Hamid-R-Tanhaei/Signal-Generator/Extras/App.png

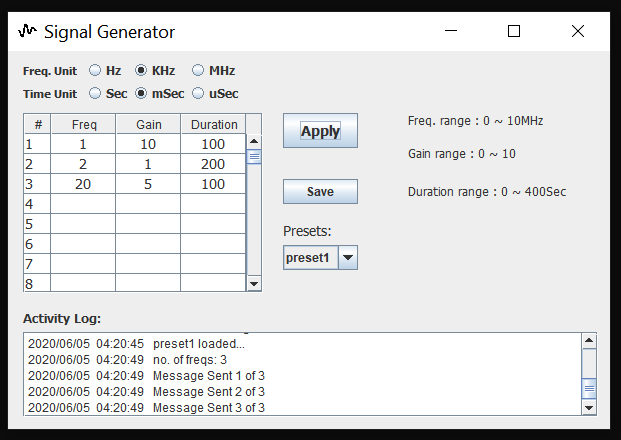
Extras/App.png
