Hamid-R-Tanhaei/Signal-Generator/PCB_Schematic/schematic.PDF

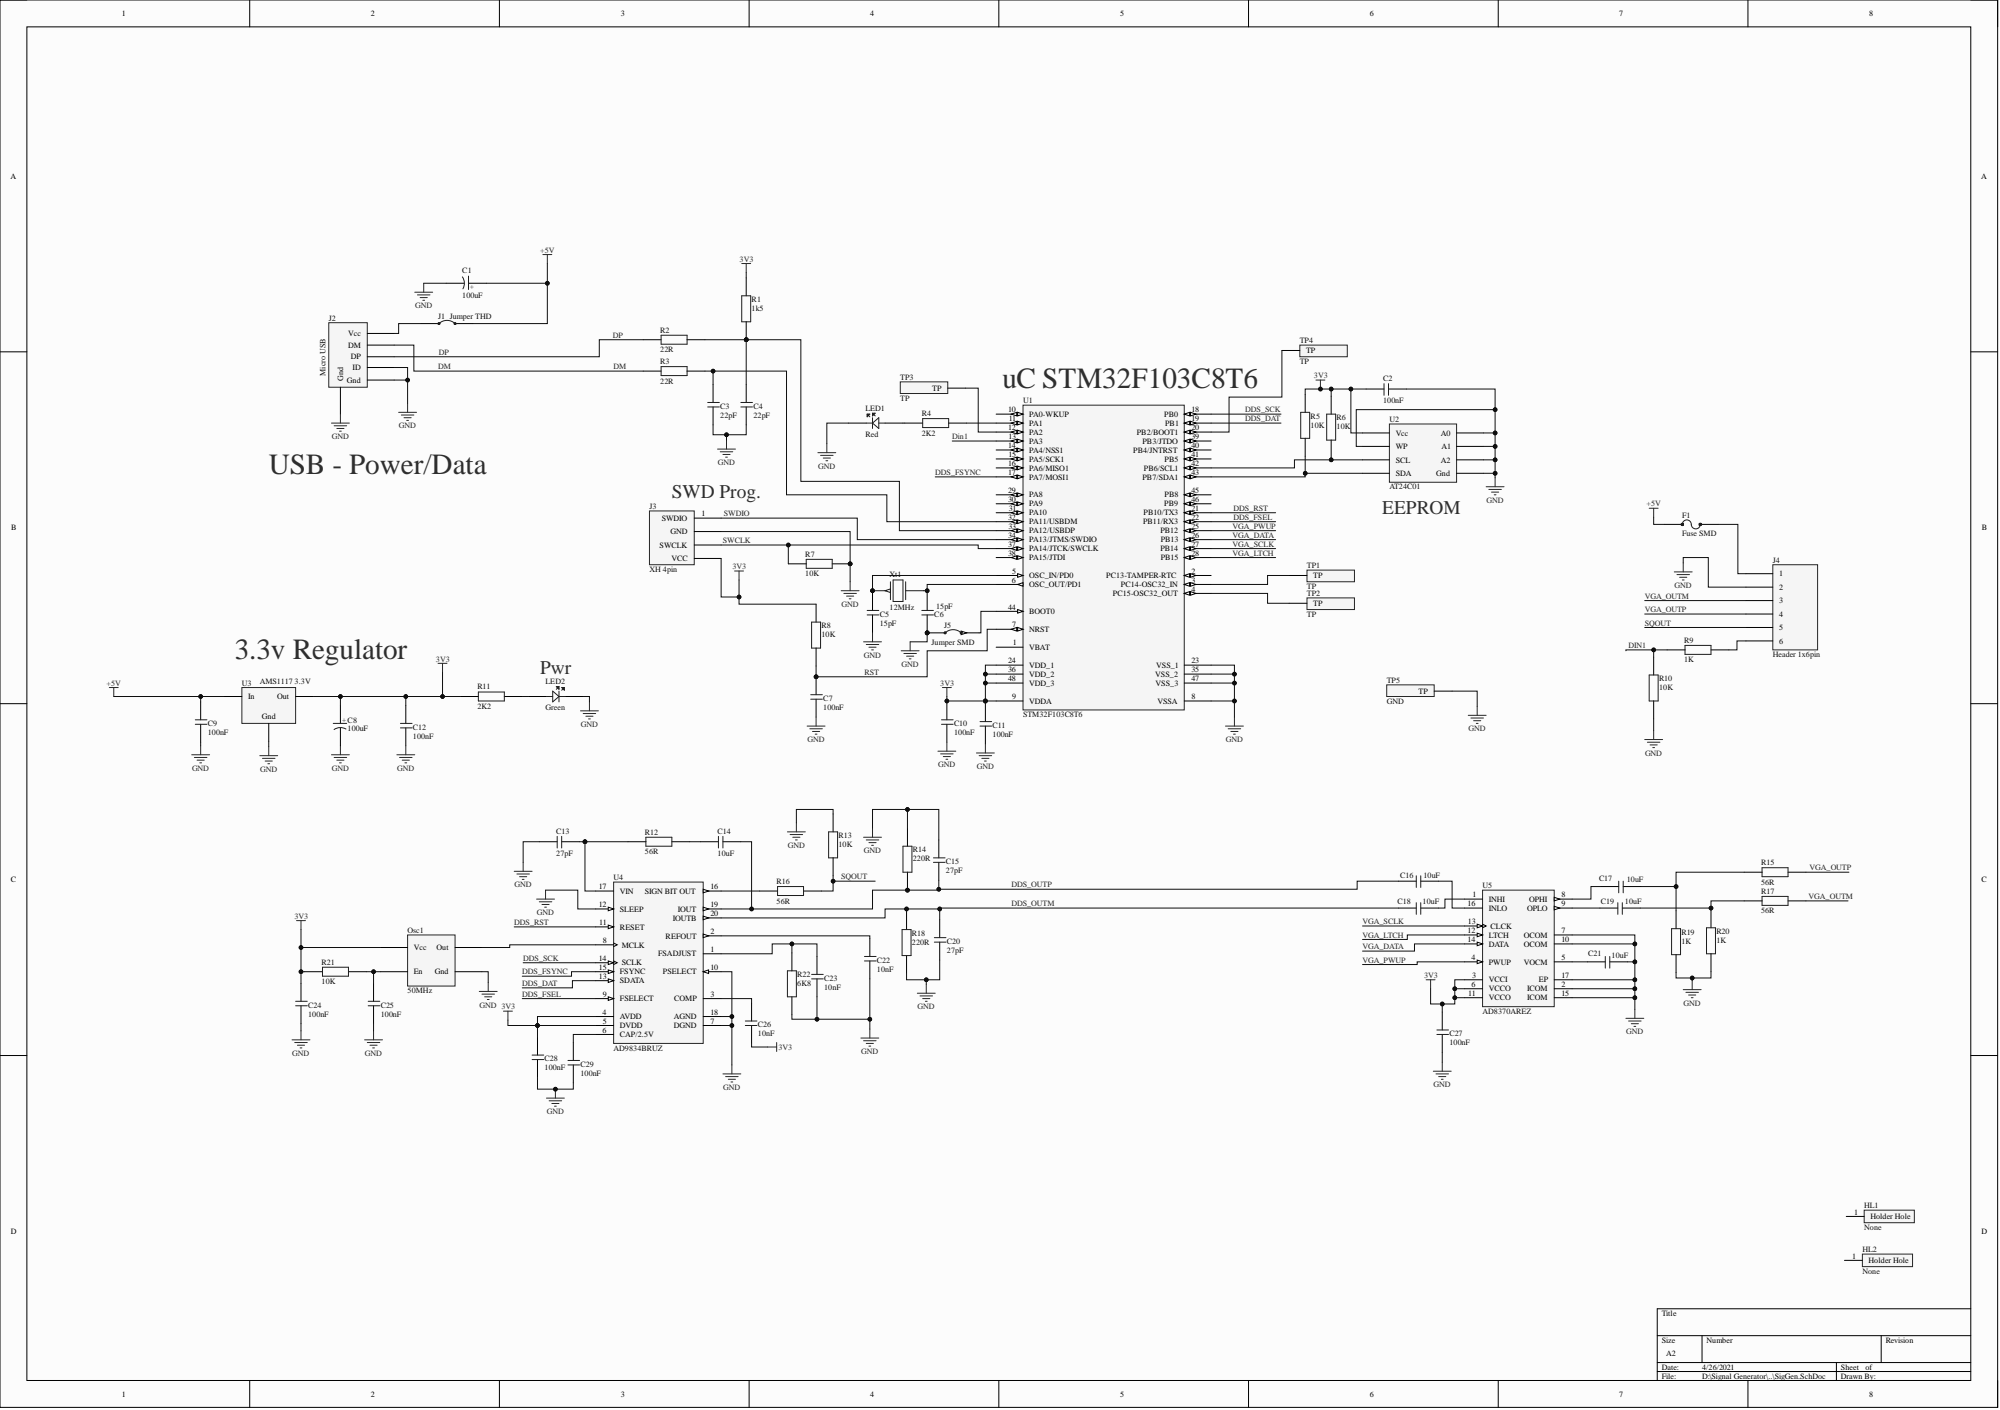
[picture p5: page 1]

PA12/USBDP 33

SWCLK | | PA14/JTCK/SWCLK 37

R7 | | PA15/JTDI 38

OSC_OUT/PD1 6

NRST 7
