Hamid-R-Tanhaei/Signal-Generator/(list of files, drawings)

Other design files:
PCB_Schematic/SigGen.SchDoc
