Hamid-R-Tanhaei/Signal-Generator/(notices)

Notices in the files:
Firmware_STM32F103c8t6/Src/main.c:
© Copyright (c) 2019 STMicroelectronics.
All rights reserved.
This software component is licensed by ST under BSD 3-Clause license,
the "License"; You may not use this file except in compliance with the
License. You may obtain a copy of the License at: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
Firmware_STM32F103c8t6/Inc/main.h:
(C) COPYRIGHT STMicroelectronics *****END OF FILE
